GiacomoGobbo/H2-Sense/PowerBoard_schematic.pdf

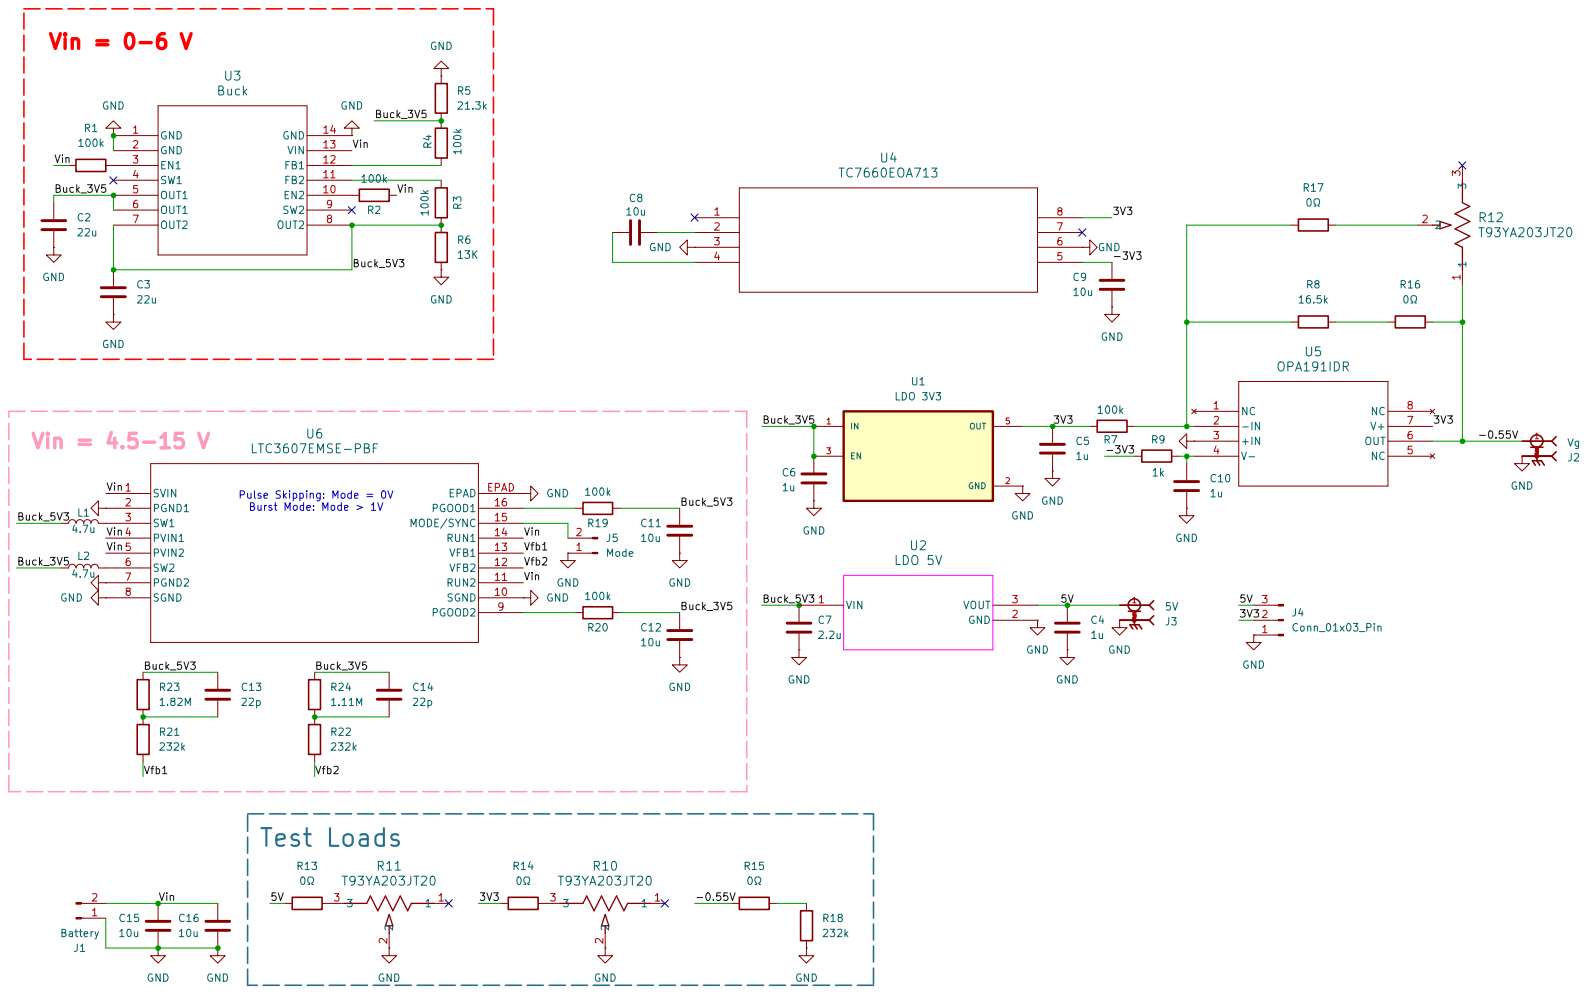
[picture p1: page 1]
