GiacomoGobbo/H2-Sense/SensorNode/PowerBoard/PowerBoard.kicad_pcb

## KiCad design SensorNode/PowerBoard/PowerBoard.kicad_pcb (2026-11-11)

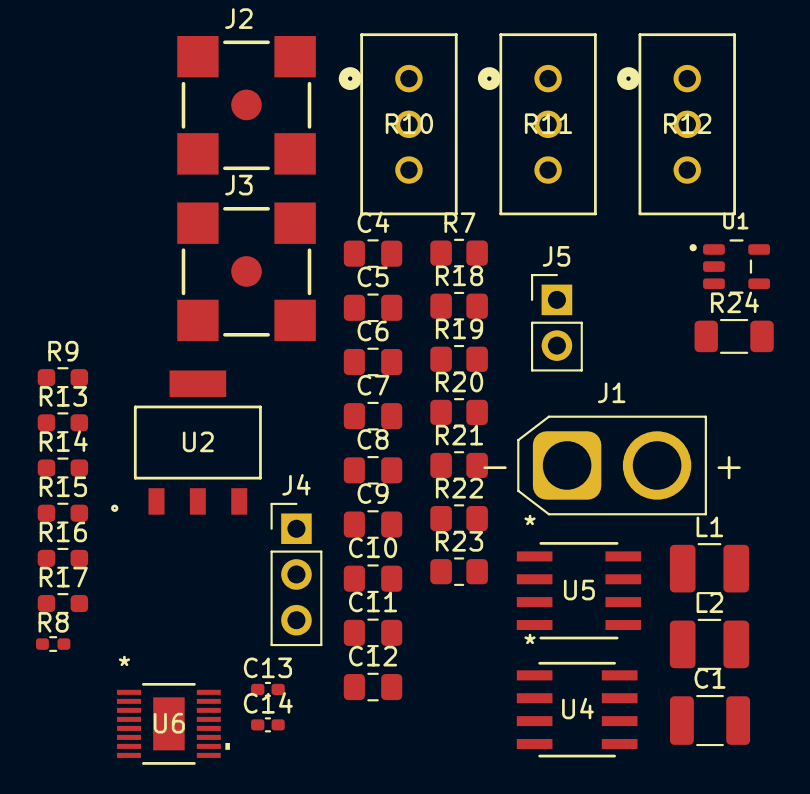
[picture p2: board PowerBoard.kicad_pcb from above]

Board: 2 copper layers, 42 parts (0 on the bottom side), 26 nets, no tracks yet.

Parts:
C1: 22u; C_1210_3225Metric_Pad1.33x2.70mm_HandSolder
C4, C5, C6, C10: 1u; C_0805_2012Metric_Pad1.18x1.45mm_HandSolder
C7: 2.2u; C_0805_2012Metric_Pad1.18x1.45mm_HandSolder
C8, C9, C11, C12: 10u; C_0805_2012Metric_Pad1.18x1.45mm_HandSolder
C13, C14: 22p; C_0402_1005Metric_Pad0.74x0.62mm_HandSolder
J1: Battery; AMASS_XT30U-M_1x02_P5.0mm_Vertical
J2: Vg; SAMTEC_SMA-J-P-GF-RA-SM1
J3: 5V; SAMTEC_SMA-J-P-GF-RA-SM1
J4: Conn_01x03_Pin; PinHeader_1x03_P2.54mm_Vertical
J5: Mode; PinHeader_1x02_P2.54mm_Vertical
L1, L2: 4.7u; L_1210_3225Metric_Pad1.42x2.65mm_HandSolder
R7, R19, R20: 100k; R_0805_2012Metric_Pad1.20x1.40mm_HandSolder
R8: 16.5k; R_0402_1005Metric_Pad0.72x0.64mm_HandSolder
R9: 1k; R_0603_1608Metric_Pad0.98x0.95mm_HandSolder
R10, R11, R12: T93YA203JT20; POT_T93YA_VIS
R13, R14, R15, R16, R17: 0Ω; R_0603_1608Metric_Pad0.98x0.95mm_HandSolder
R18, R21, R22: 232k; R_0805_2012Metric_Pad1.20x1.40mm_HandSolder
R23: 1.82M; R_0805_2012Metric_Pad1.20x1.40mm_HandSolder
R24: 1.11M; R_1206_3216Metric_Pad1.30x1.75mm_HandSolder
U1: LDO 3V3; SOT95P280X145-5N
U2: LDO 5V; SOT-223_3MC_MCH
U4: TC7660EOA713; SOIC8-N_MC_MCH
U5: OPA191IDR; D0008A_TEX
U6: LTC3607EMSE-PBF; MSOP-16_MSE_LIT

Connections:
/3V3: C5.1, J4.2, R7.2, R14.1, U1.5 (OUT), U4.8, U5.7 (V+)
/5V: C4.1, J3.1, J4.3, R13.1, U2.3 (VOUT)
/-0.55V: J2.1, R12.1, R15.1, R16.2, U5.6 (OUT)
/-3V3: C9.1, R9.1, U4.5
/Buck_3V5: C6.1, C12.1, C14.1, L2.1, R20.1, R24.1, U1.1 (IN), U1.3 (EN)
/Buck_5V3: C7.1, C11.1, C13.1, L1.1, R19.1, R23.1, U2.1 (VIN)
/Vfb1: R21.2, U6.13 (VFB1)
/Vfb2: R22.2, U6.12 (VFB2)
/Vin: C1.1, J1.2, U6.1 (SVIN), U6.4 (PVIN1), U6.5 (PVIN2), U6.11 (RUN2), U6.14 (RUN1)
GND: C1.2, C4.2, C5.2, C6.2, C7.2, C9.2, C10.2, C11.2, C12.2, J1.1, J2.2, J2.3, J2.4, J2.5, J3.2, J3.3, J3.4, J3.5, J4.1, J5.1, R10.2, R11.2, R18.1, U1.2 (GND), U2.2 (GND), U4.3, U4.6, U5.3 (+IN), U6.2 (PGND1), U6.7 (PGND2), U6.8 (SGND), U6.10 (SGND), U6.EPAD
unnamed: C8.1, U4.4
unnamed: C8.2, U4.2
unnamed: C13.2, R21.1, R23.2
unnamed: C14.2, R22.1, R24.2
unnamed: J5.2, U6.15 (MODE/SYNC)
unnamed: R10.3, R14.2
unnamed: R11.3, R13.2
unnamed: R12.2, R17.1
unnamed: R15.2, R18.2
unnamed: R8.2, R16.1
unnamed: R7.1, R8.1, R17.2, U5.2 (-IN)
unnamed: C10.1, R9.2, U5.4 (V-)
unnamed: R19.2, U6.16 (PGOOD1)
unnamed: R20.2, U6.9 (PGOOD2)
unnamed: L1.2, U6.3 (SW1)
unnamed: L2.2, U6.6 (SW2)
