GiacomoGobbo/H2-Sense/SensorNode/SensorNode.kicad_pcb

## KiCad design SensorNode/SensorNode.kicad_pcb (2026-11-11)

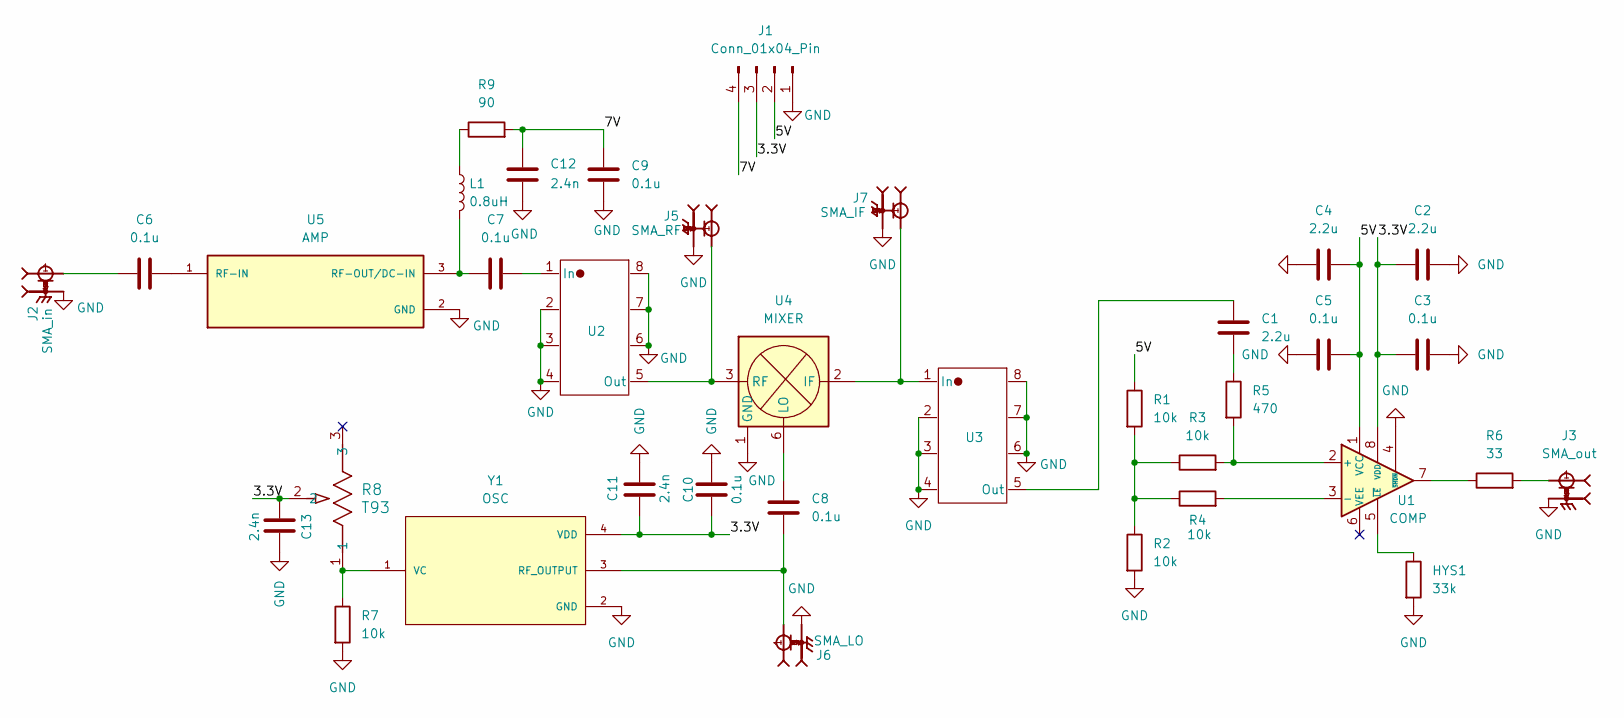
[picture p3: schematic SensorNode.kicad_sch, H2 Sensor Node]

Parts:
C1, C2, C4: 2.2u; C_0805_2012Metric_Pad1.18x1.45mm_HandSolder
C3, C5, C6, C7, C8, C9, C10: 0.1u; C_0603_1608Metric_Pad1.08x0.95mm_HandSolder
C11, C12, C13: 2.4n; C_0805_2012Metric_Pad1.18x1.45mm_HandSolder
HYS1: 33k; R_0805_2012Metric_Pad1.20x1.40mm_HandSolder
J1: Conn_01x04_Pin; PinHeader_1x04_P2.54mm_Vertical
J2: SMA_in; SAMTEC_SMA-J-P-GF-RA-SM1; MPN SMA-J-P-GF-RA-SM1
J3: SMA_out; SAMTEC_SMA-J-P-GF-RA-SM1; MPN SMA-J-P-GF-RA-SM1
J5: SMA_RF; SAMTEC_SMA-J-P-GF-RA-SM1; MPN SMA-J-P-GF-RA-SM1
J6: SMA_LO; SAMTEC_SMA-J-P-GF-RA-SM1; MPN SMA-J-P-GF-RA-SM1
J7: SMA_IF; SAMTEC_SMA-J-P-GF-RA-SM1; MPN SMA-J-P-GF-RA-SM1
L1: 0.8uH; L_0805_2012Metric_Pad1.05x1.20mm_HandSolder
R1, R2, R3, R4, R7: 10k; R_0201_0603Metric_Pad0.64x0.40mm_HandSolder
R5: 470; R_0603_1608Metric_Pad0.98x0.95mm_HandSolder
R6: 33; R_1206_3216Metric_Pad1.30x1.75mm_HandSolder
R8: T93; POT_T93YA_VIS
R9: 90; R_0603_1608Metric_Pad0.98x0.95mm_HandSolder
U1: COMP; MSOP-8_3x3mm_P0.65mm
U2, U3: SCLF
U4: MIXER; Mini-Circuits_CD542_LandPatternPL-052
U5: AMP; IC_ERA-6SM_; MPN ERA-6SM+
Y1: OSC; XTAL_ABLNO-V-104.000MHZ-T; MPN ABLNO-V-104.000MHZ

Connections:
/3.3V: C2.1, C3.1, C10.1, C11.2, C13.2, J1.3, R8.2, U1.8 (VDD), Y1.4 (VDD); also elsewhere on the board
/5V: C4.2, C5.2, J1.2, R1.1, U1.1 (VCC); also elsewhere on the board
/7V: C9.2, C12.1, J1.4, R9.2
GND: C2.2, C3.2, C4.1, C5.1, C9.1, C10.2, C11.1, C12.2, C13.1, HYS1.2, J1.1, J2.2, J2.3, J2.4, J2.5, J3.2, J3.3, J3.4, J3.5, J5.2, J5.3, J5.4, J5.5, J6.2, J6.3, J6.4, J6.5, J7.2, J7.3, J7.4, J7.5, R2.2, R7.2, U1.4 (~SHDN), U2.2, U2.3, U2.4, U2.6, U2.7, U2.8, U3.2, U3.3, U3.4, U3.6, U3.7, U3.8, U4.1 (GND), U4.4 (GND), U4.5 (GND), U5.2 (GND), U5.4 (GND), Y1.2 (GND); also elsewhere on the board
unnamed: C1.2, R5.1
unnamed: C6.1, J2.1
unnamed: J3.1, R6.2
unnamed 7: L1.1, R9.1; also elsewhere on the board
unnamed: R1.2, R2.1, R3.1, R4.1
unnamed 9: R6.1, U1.7; also elsewhere on the board
unnamed 10: R3.2, R5.2, U1.2 (+); also elsewhere on the board
unnamed 11: R4.2, U1.3 (-); also elsewhere on the board
unnamed 12: HYS1.1, U1.5 (~LE); also elsewhere on the board
unnamed: C7.2, U2.1 (In)
unnamed: J5.1, U2.5 (Out), U4.3 (RF)
unnamed: J7.1, U3.1 (In), U4.2 (IF)
unnamed: C1.1, U3.5 (Out)
unnamed: C8.2, U4.6 (LO)
unnamed: C6.2, U5.1 (RF-IN)
unnamed 19: C7.1, L1.2, U5.3 (RF-OUT/DC-IN); also elsewhere on the board
unnamed 20: C8.1, J6.1, Y1.3 (RF_OUTPUT); also elsewhere on the board
unnamed 21: R7.1, R8.1, Y1.1 (VC); also elsewhere on the board

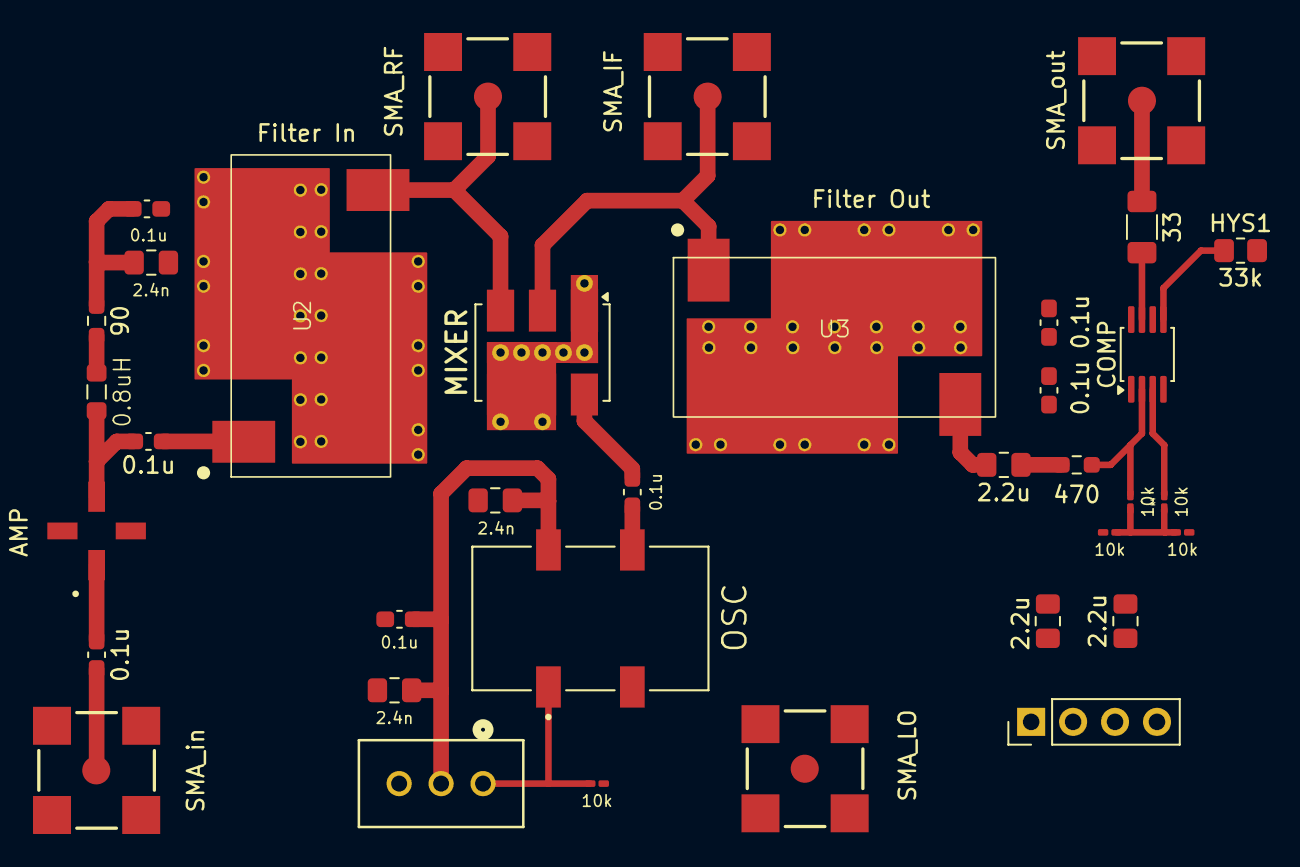
[picture p4: board SensorNode.kicad_pcb from above]

Board: 2 copper layers, 36 parts (0 on the bottom side), 22 nets.

Other parts of the board:
0.8uH: 0.8uH; L_0805_2012Metric_Pad1.05x1.20mm_HandSolder
COMP: LTC6752xMS8-2; MSOP-8_3x3mm_P0.65mm
OSC: OSC; XTAL_ABLNO-V-104.000MHZ-T

Their connections:
/3.3V: COMP.8 (VDD), OSC.4 (VDD); also elsewhere on the board
/5V: COMP.1 (VCC); also elsewhere on the board
GND: COMP.4 (~SHDN), OSC.2 (GND); also elsewhere on the board
unnamed 7: 0.8uH.1; also elsewhere on the board
unnamed 9: COMP.7; also elsewhere on the board
unnamed 10: COMP.2 (+); also elsewhere on the board
unnamed 11: COMP.3 (-); also elsewhere on the board
unnamed 12: COMP.5 (~LE); also elsewhere on the board
unnamed 19: 0.8uH.2; also elsewhere on the board
unnamed 20: OSC.3 (RF_OUTPUT); also elsewhere on the board
unnamed 21: OSC.1 (VC); also elsewhere on the board
