GiacomoGobbo/H2-Sense/(commit log)

2026-11-11 Added SensorBoard and PowerBoard
    First Commit
    [SensorNode.kicad_pcb, SensorNode.kicad_sch]
2026-11-11 Aggiunto progetto PowerBoard
    [PowerBoard.kicad_pcb, PowerBoard.kicad_sch]
2026-11-11 Add README.md with project details and guidelines
    Added detailed documentation for PCB projects including SensorNode and PowerBoard specifications.
2026-11-11 Revise README for H2Sense Boards project
    Updated project name and description in README.md. Enhanced details about the sensor node and power board functionalities.
2026-11-13 Enhance README with image and formatting updates
    Added an image to the PowerBoard section and improved formatting.
